abaffa/DIY-VideoRAM/README.md

# DIY-VideoRAM

NEW: I've build a VGA Extension Card for the 'Minimal CPU System': https://github.com/slu4coder/Minimal-UART-CPU-System

Project files for my DIY video RAM I built from TTL chips as a learning experience. Use at your own risk. Have fun!
