abaffa/DIY-VideoRAM/(list of files, drawings)

Other design files:
KiCAD/Minimal Expansion VGA Card/VideoRAM.dsn
