abaffa/DIY-VideoRAM/KiCAD/Minimal Expansion VGA Card/VideoRAM.kicad_pcb

## KiCad design KiCAD/Minimal Expansion VGA Card/VideoRAM.kicad_pcb (2021-12-17)

Schematic: VideoRAM.sch, Minimal VGA Card

Parts:
C1: 47µF; CP_Radial_D6.3mm_P2.50mm
C2, C3, C4, C5, C6, C7, C8, C9, C10, C12, C13, C14: 100nF; C_Disc_D3.8mm_W2.6mm_P2.50mm
C11: 100pF; C_Disc_D3.8mm_W2.6mm_P2.50mm
J1: EXPANSION PORT; PinSocket_2x16_P2.54mm_Vertical
J2: VGA connector; VGA DSUB15HD_female
J3: EXT CLOCK; PinHeader_1x02_P2.54mm_Vertical
R1, R2: 75; R_Axial_DIN0207_L6.3mm_D2.5mm_P7.62mm_Horizontal
R3: 150; R_Axial_DIN0207_L6.3mm_D2.5mm_P7.62mm_Horizontal
U1, U8: 74HC32; DIP-14_W7.62mm
U2, U4: 74HC21; DIP-14_W7.62mm
U3: 74HC04; DIP-14_W7.62mm
U5, U6: 74HC590; DIP-16_W7.62mm
U7, U11, U19: 74HC00; DIP-14_W7.62mm
U9, U10, U14: 74HC245; DIP-20_W7.62mm
U12: CY62256; DIP-28_W15.24mm
U13: 74HC165; DIP-16_W7.62mm
U15, U16, U17, U18: 74HC173; DIP-16_W7.62mm

Connections:
2MHz: U3.4, U5.11 (CPC), U5.13 (CPR), U6.11 (CPC), U6.13 (CPR), U15.7 (Cp), U16.7 (Cp), U17.7 (Cp), U18.7 (Cp)
4MHz: C11.1, J3.1, U1.12
16MHz: J3.2, U11.9, U11.10
+5V: C1.1, C2.1, C3.1, C4.1, C5.1, C6.1, C7.1, C8.1, C9.1, C10.1, C12.1, C13.1, C14.1, J1.3, U1.14 (VCC), U2.14, U3.14 (VCC), U4.14, U5.16 (VCC), U6.16 (VCC), U7.14 (VCC), U8.14 (VCC), U9.20 (VCC), U10.20 (VCC), U11.14 (VCC), U12.28 (VCC), U13.16 (VCC), U14.20 (VCC), U15.16 (VCC), U16.16 (VCC), U17.16 (VCC), U18.16 (VCC), U19.14 (VCC)
/Bus0: J1.9, U14.18 (B0), U16.14 (D0), U18.14 (D0)
/Bus1: J1.10, U14.17 (B1), U16.13 (D1), U18.13 (D1)
/Bus2: J1.11, U14.16 (B2), U16.12 (D2), U18.12 (D2)
/Bus3: J1.12, U14.15 (B3), U16.11 (D3), U18.11 (D3)
/Bus4: J1.13, U14.14 (B4), U15.14 (D0), U17.14 (D0)
/Bus5: J1.14, U14.13 (B5), U15.13 (D1), U17.13 (D1)
/Bus6: J1.15, U14.12 (B6), U15.12 (D2), U17.12 (D2)
/Bus7: J1.16, U14.11 (B7), U15.11 (D3), U17.11 (D3)
/CLOCK: J1.5, U1.13, U3.1
/H1: U6.15 (Q0), U10.18 (B0)
/H2: U6.1 (Q1), U10.17 (B1)
/H4: U6.2 (Q2), U10.16 (B2)
/H8: U1.2, U6.3 (Q3), U10.15 (B3)
/H16: U1.1, U6.4 (Q4), U10.14 (B4)
/H32: U1.5, U6.5 (Q5), U10.13 (B5)
/M2: J1.19, U11.12
/M3: J1.20, U2.9
/M4: J1.21, U2.1
/M5: J1.22, U2.2
/M6: J1.23, U2.4
/M7: J1.24, U2.5
/M8: J1.25, U4.9
/M9: J1.26, U4.10
/M10: J1.27, U4.12
/M11: J1.28, U4.13
/M12: J1.29, U4.1
/M13: J1.30, U3.9
/M14: J1.31, U4.4
/M15: J1.32, U4.5
/RI: J1.6, U3.5, U8.1
/RO: U3.10, U8.2, U14.1 (A->B)
/V1: U6.7 (Q7), U7.12, U7.13, U10.11 (B7)
/V2: U5.15 (Q0), U9.18 (B0)
/V4: U5.1 (Q1), U7.1, U9.17 (B1)
/V8: U5.2 (Q2), U9.16 (B2)
/V16: U5.3 (Q3), U9.15 (B3)
/V32: U5.4 (Q4), U9.14 (B4)
/V64: U5.5 (Q5), U9.13 (B5)
/V128: U5.6 (Q6), U9.12 (B6)
/V256: U5.7 (Q7), U7.2, U9.11 (B7)
/~INH: J1.8, U8.5, U8.13, U11.11
/~RI: U3.6, U8.12, U15.10 (E2), U16.10 (E2), U17.10 (E2), U18.10 (E2)
/~RO: J1.7, U3.11
GND: C1.2, C2.2, C3.2, C4.2, C5.2, C6.2, C7.2, C8.2, C9.2, C10.2, C11.2, C12.2, C13.2, C14.2, J1.1, J2.5, J2.6, J2.7, J2.8, J2.10, U1.7 (GND), U2.7, U3.7 (GND), U3.13, U4.7, U5.8 (GND), U5.14 (~OE), U6.8 (GND), U6.12 (~CE), U6.14 (~OE), U7.7 (GND), U8.7 (GND), U9.1 (A->B), U9.10 (GND), U10.1 (A->B), U10.10 (GND), U11.7 (GND), U12.10 (A14), U12.14 (GND), U12.20 (~CE), U12.22 (~OE), U13.8 (GND), U13.10 (DS), U13.15 (~CE), U14.10 (GND), U15.8 (GND), U15.15 (Mr), U16.8 (GND), U16.15 (Mr), U17.8 (GND), U17.15 (Mr), U18.8 (GND), U18.15 (Mr), U19.7 (GND), U19.12, U19.13
unnamed: J2.1, J2.2, J2.3, R3.1
unnamed: J2.13, R2.1
unnamed: J2.14, R1.1
unnamed: R1.2, U7.5, U7.8
unnamed: R2.2, U1.6
unnamed: R3.2, U13.9 (Q7)
unnamed: U1.3, U1.4
unnamed: U1.9, U1.10, U1.11, U19.5
unnamed: U2.6, U2.10
unnamed: U2.12, U4.8
unnamed: U2.13, U4.6
unnamed: U3.8, U4.2
unnamed: U5.10 (~MRC), U6.10 (~MRC), U7.3, U7.4
unnamed: U5.12 (~CE), U6.9 (~RCO)
unnamed: U7.6, U7.9
unnamed: U7.10, U7.11
unnamed: U8.10, U8.11
unnamed: U10.2 (A0), U12.21 (A0), U18.3 (Q0)
unnamed: U10.3 (A1), U12.23 (A1), U18.4 (Q1)
unnamed: U10.4 (A2), U12.24 (A2), U18.5 (Q2)
unnamed: U10.5 (A3), U12.25 (A3), U18.6 (Q3)
unnamed: U10.6 (A4), U12.26 (A4), U17.3 (Q0)
unnamed: U10.7 (A5), U12.1 (A5), U17.4 (Q1)
unnamed: U10.9 (A7), U12.2 (A6), U17.5 (Q2)
unnamed: U6.6 (Q6), U10.12 (B6)
unnamed: U11.3, U17.9 (E1), U18.9 (E1)
unnamed: U11.6, U15.9 (E1), U16.9 (E1)
unnamed: U9.2 (A0), U12.3 (A7), U17.6 (Q3)
unnamed: U9.3 (A1), U12.4 (A8), U16.3 (Q0)
unnamed: U9.4 (A2), U12.5 (A9), U16.4 (Q1)
unnamed: U9.5 (A3), U12.6 (A10), U16.5 (Q2)
unnamed: U9.6 (A4), U12.7 (A11), U16.6 (Q3)
unnamed: U9.7 (A5), U12.8 (A12), U15.3 (Q0)
unnamed: U9.8 (A6), U12.9 (A13), U15.4 (Q1)
unnamed: U12.11 (I/O0), U13.11 (D0), U14.2 (A0)
unnamed: U12.12 (I/O1), U13.12 (D1), U14.3 (A1)
unnamed: U12.13 (I/O2), U13.13 (D2), U14.4 (A2)
unnamed: U12.15 (I/O3), U13.14 (D3), U14.5 (A3)
unnamed: U12.16 (I/O4), U13.3 (D4), U14.6 (A4)
unnamed: U12.17 (I/O5), U13.4 (D5), U14.7 (A5)
unnamed: U12.18 (I/O6), U13.5 (D6), U14.8 (A6)
unnamed: U12.19 (I/O7), U13.6 (D7), U14.9 (A7)
unnamed: U8.8, U12.27 (~WE)
unnamed: U13.1 (~PL), U19.6
unnamed: U8.6, U14.19 (CE)
unnamed: U8.4, U19.8
unnamed: U8.3, U19.9
PIXEL: U11.8, U13.2 (CP)
T_VRAM: U1.8, U9.19 (CE), U10.19 (CE), U19.1, U19.2, U19.10
~2MHz: U3.2, U3.3, U8.9
~T_VRAM: U15.1 (Oe1), U15.2 (Oe2), U16.1 (Oe1), U16.2 (Oe2), U17.1 (Oe1), U17.2 (Oe2), U18.1 (Oe1), U18.2 (Oe2), U19.3, U19.4

Notes on the sheet:
~HSYNC
~VSYNC
During the first phase, the VRAM address is controlled by the timer.
During the second phase, the VRAM address is controlled by the MSB/LSB access register.
The address LSB is sampled from the bus if ~VGA_RANGE~=LOW and M0=1, e. g. MAR=0xdff9, and RI is active.
~PL~ happens in the middle of the first half of the clock cycle when the VRAM output is still controlled by the VGA timer.
The address MSB is sampled from the bus if ~VGA_RANGE~=LOW and M1=1, e. g. MAR=0xdffa, and RI is active.
~INH~ is only LOW if MAR = 0b11011111111111xx = 0xdffc-0xdfff, i. e. data I/O ~INH~ deactivates RAM/FLASH access on the main board.
Buffer is only active while VRAM is accessed by th CPU. In case of a write access (RI) the data on the bus is present on the RAM's I/O lines. At the same time ~WE~ is LOW forcing the RAM's I/O lines to read mode. In case of a read access (RO) data from the RAM's I/O lines drives the bus.
For a stable ~PL~, signals must rise simultaneously. Since CLOCK drives a lot of ICs, 4MHz needs an additional capacitive load.
buffers the system clock to reduce capacitive load
aligns pixel shift with parallel load
VGA_RANGE is HIGH if MAR = 0b1101111111111xxx = 0xdff8-0xdfff

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
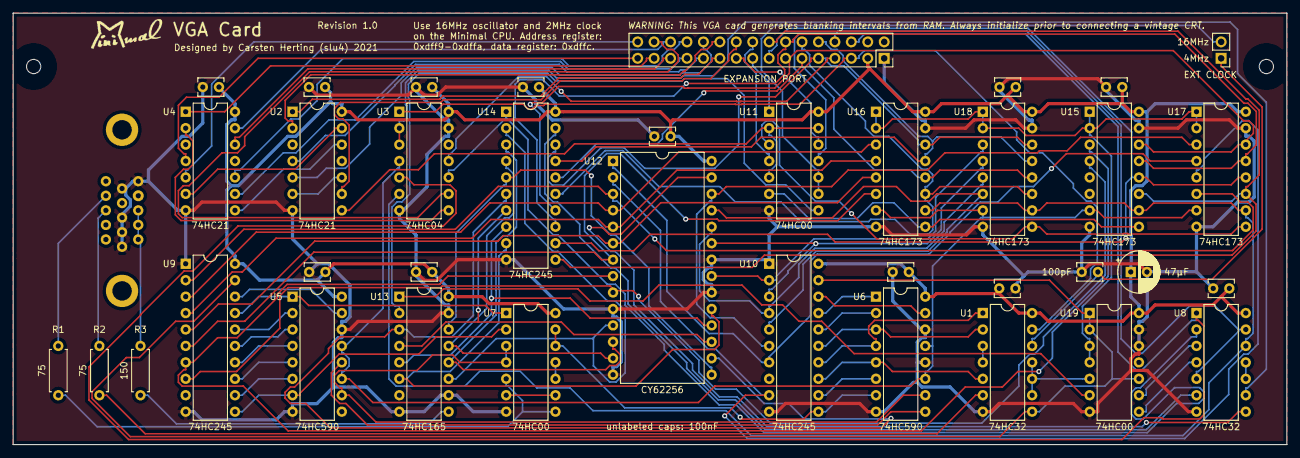
[picture p1: board VideoRAM.kicad_pcb from above]

Board: 2 copper layers, 196.8 x 66.7 mm, 41 parts (0 on the bottom side), 102 nets.

Other parts of the board:
REF1, REF2: MountingHole_2.2mm_M2
