abaffa/DIY-VideoRAM/(notices)

Notices in the files:
KiCAD/Minimal Expansion VGA Card/VideoRAM.sch:
creativecommons.org/licenses/by-nc-sa/3.0/deed.en
License: CC BY-NC-SA 3.0
